samcar17/Wave-Terrain-Synthesizer/Schematics/Wave Terrain Module v1.0 (Chapter 3).pdf

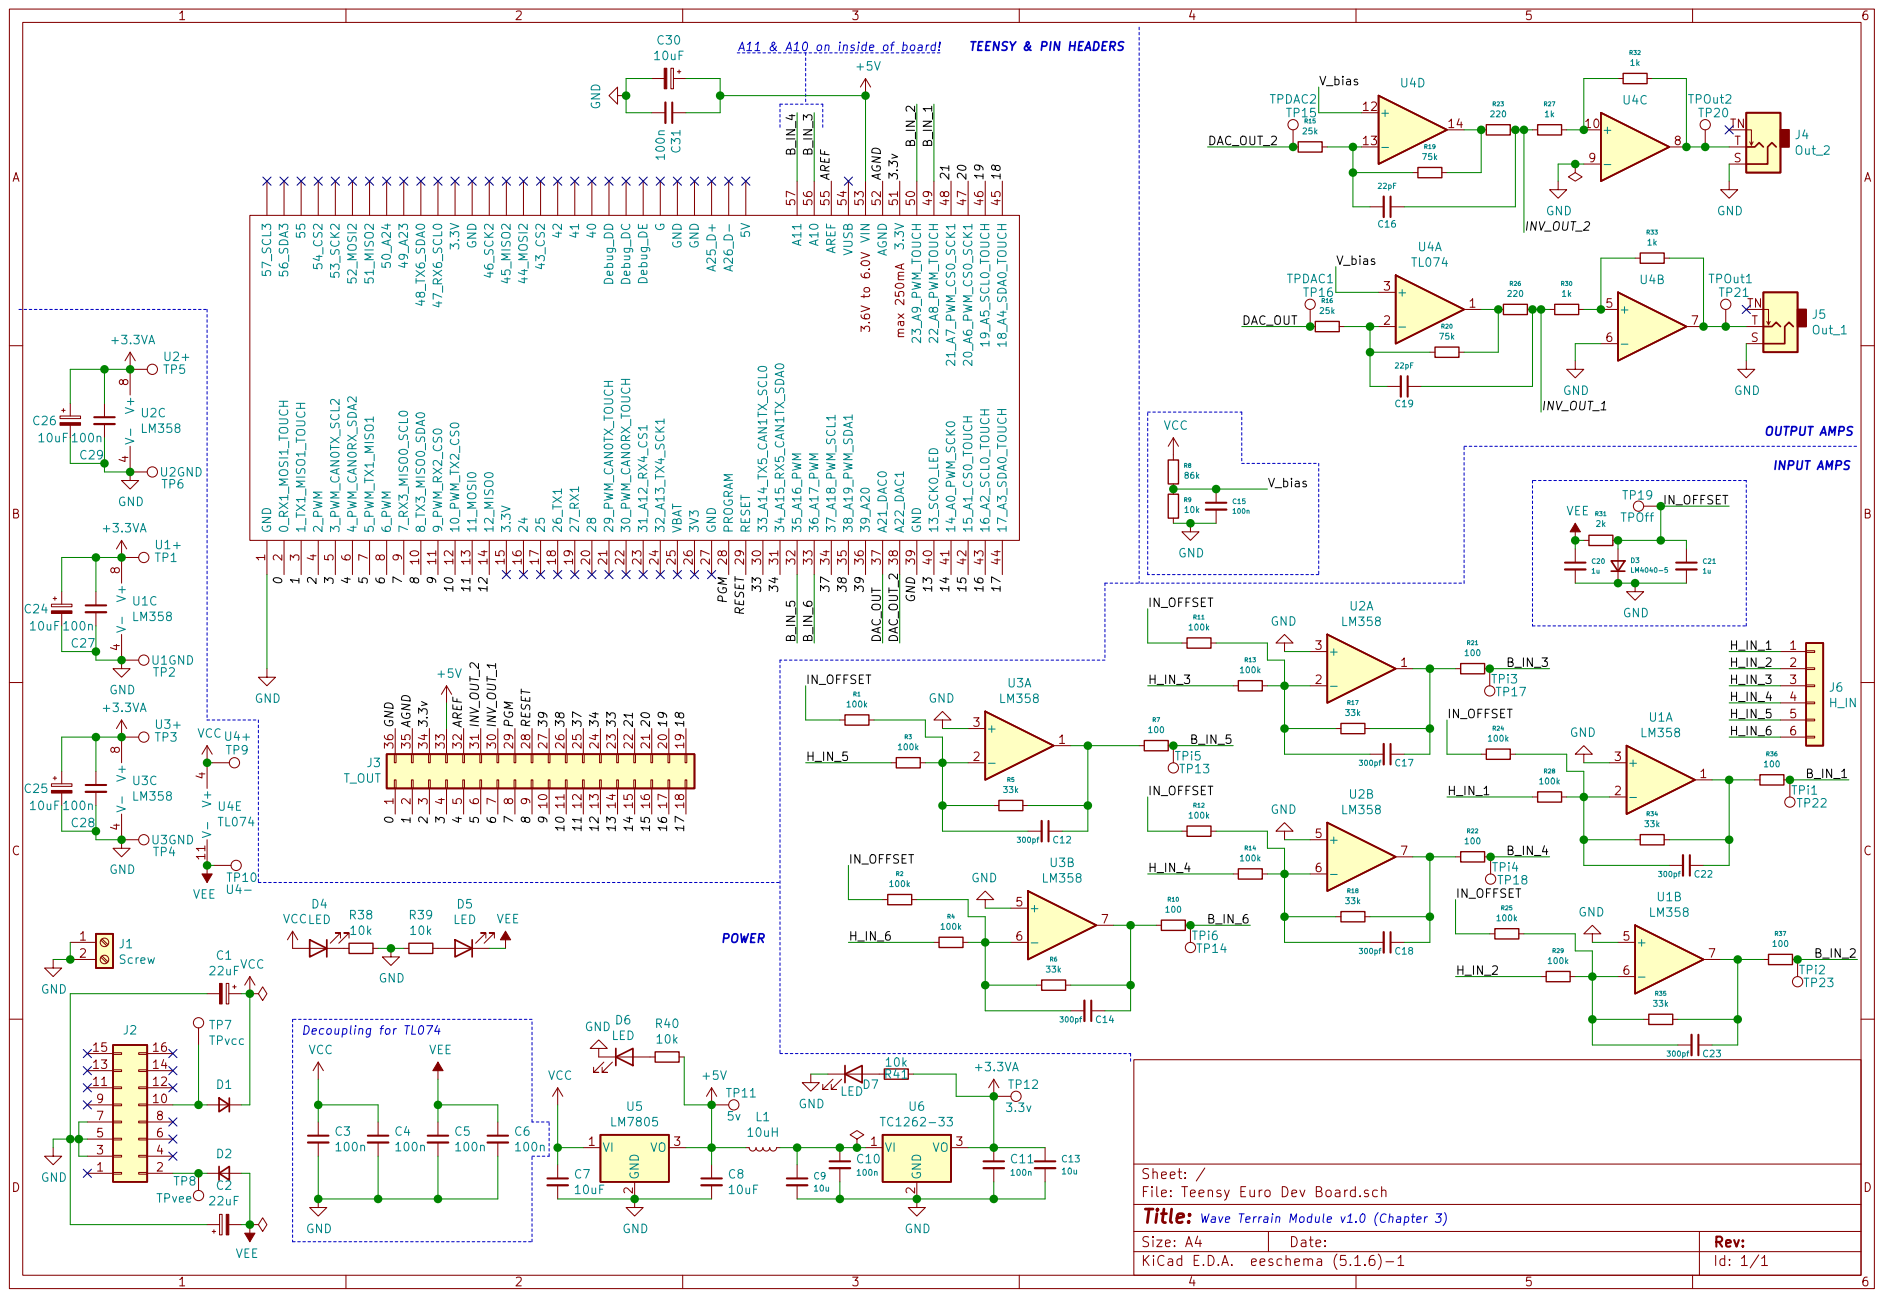
[picture p1: page 1]

5 23_A9_PWM_TOUCH 50 3.3V 51 AGND 52 VIN 53 VUSB 54 AREF 55 A10 56 A11 57 4_PWM_CAN0RX_SDA2

2 28 20 29_PWM_CAN0TX_TOUCH 21 30_PWM_CAN0RX_TOUCH 22 31_A12_RX4_CS1 23 32_A13_TX4_SCK1 24 VBAT 25 3V3 26 GND 27 PROGRAM 28 RESET 29 1_TX1_MISO1_TOUCH

File: Teensy Euro Dev Board.sch Sheet: / GND
LED

Wave Terrain Module v1.0 (Chapter 3)
