samcar17/Wave-Terrain-Synthesizer/Schematics/Wave Terrain Module v2.0 - Display Board (Chapter 4).pdf

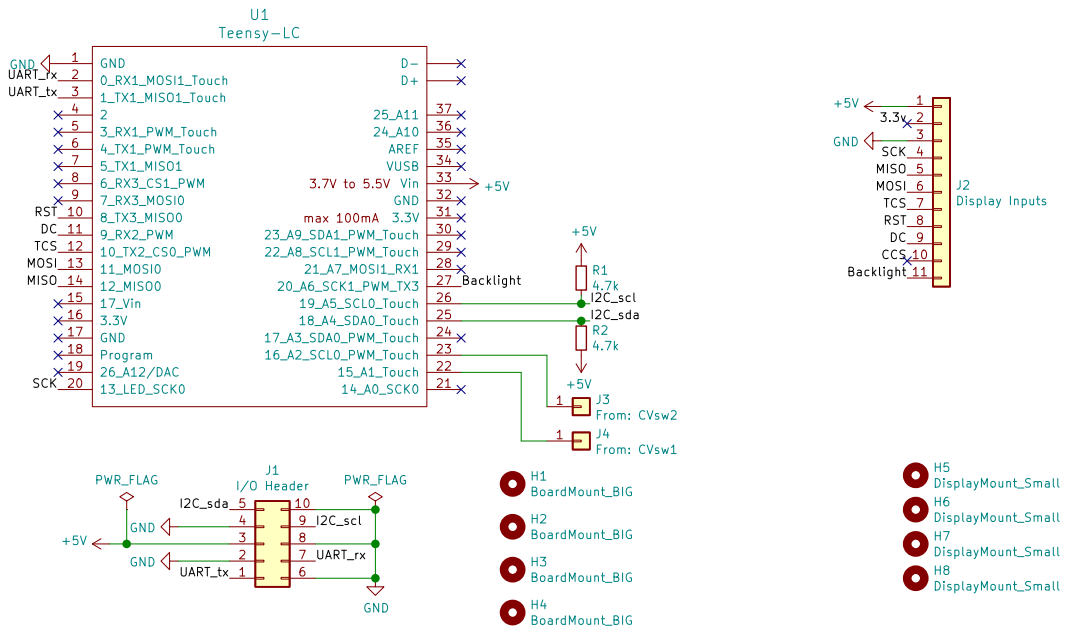
[picture p2: page 1]

Id: 1/1 Title: File: Screen PCB Schem.sch Sheet: / +5V
