samcar17/Wave-Terrain-Synthesizer/Schematics/Wave Terrain Module v2.0 - Main Board (Chapter 4).pdf

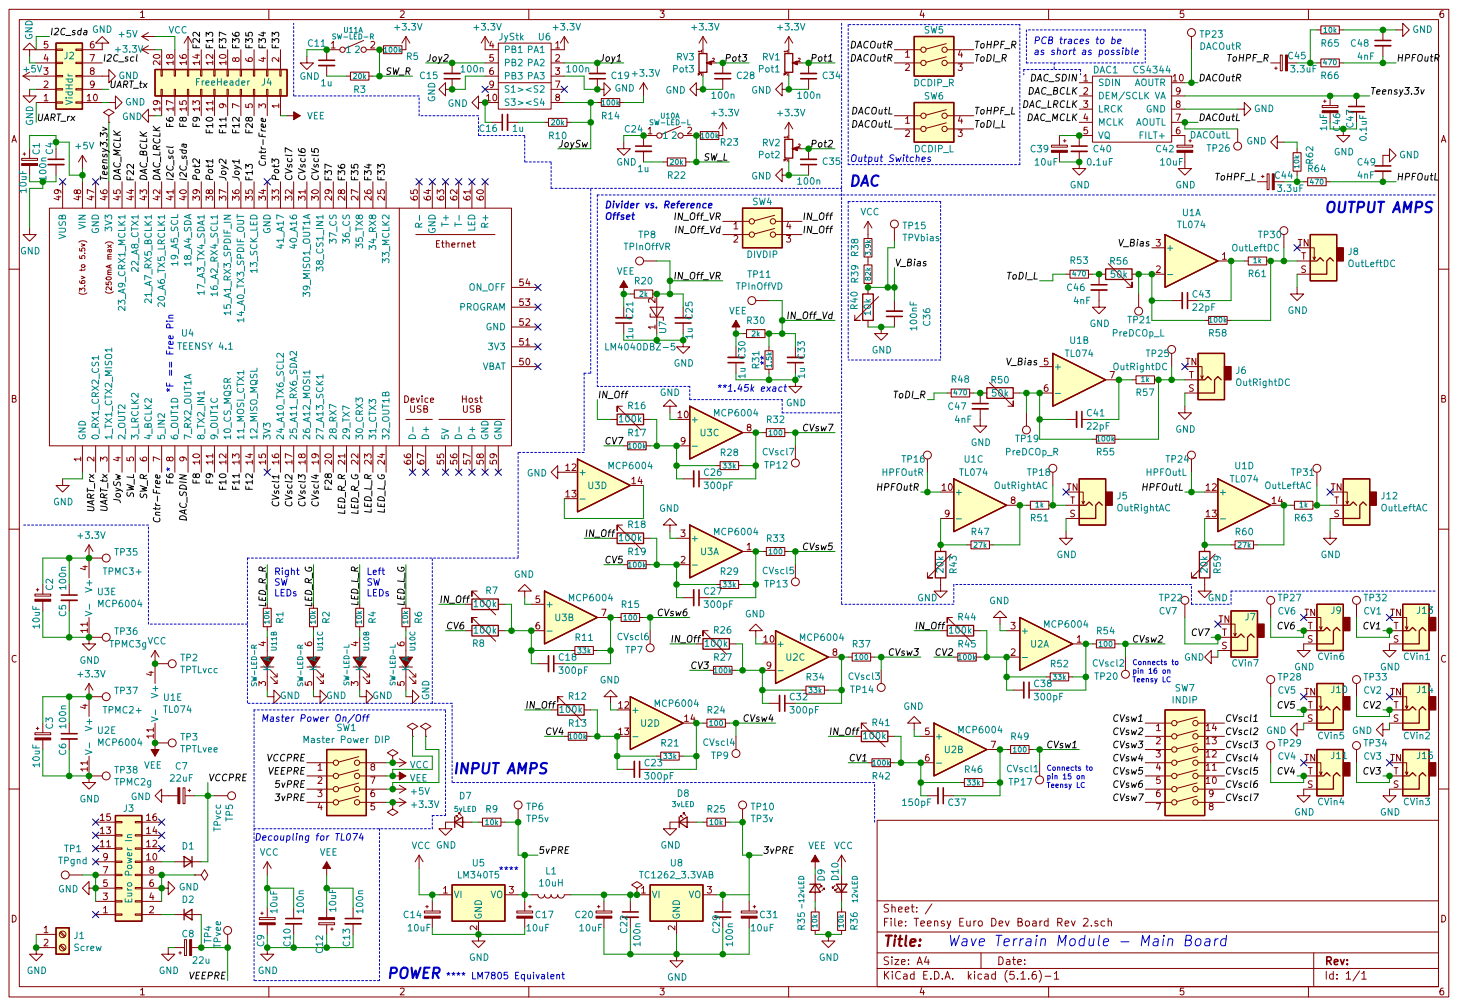
[picture p3: page 1]

PCB traces to be as short as possible

Divider vs. Reference Offset Master Power On/Off

Connects to pin 15 on Teensy LC

File: Teensy Euro Dev Board Rev 2.sch Sheet: /
Id: 1/1 Title:
