samcar17/Wave-Terrain-Synthesizer/(commit log)

2022-10-12 Uploaded Schematics
2022-10-14 Fixed wording of some comments
    Changed "orbit" to "trajectory" to be consistent with thesis
    [main.ino]
